flisboac/mixlib-kicad/mixlib-kicad.kicad_pcb

## KiCad design mixlib-kicad.kicad_pcb (2026-07-14)

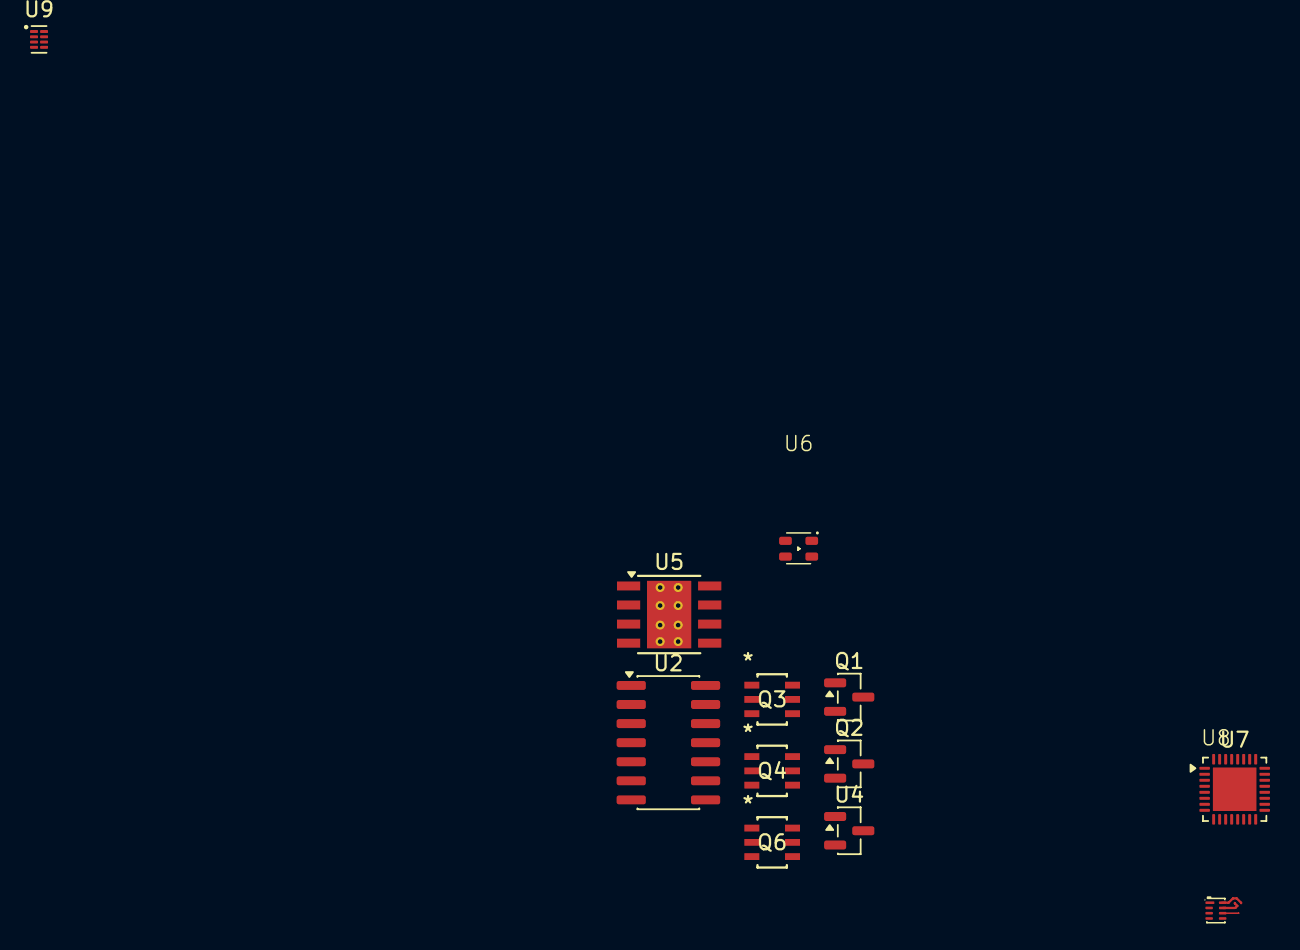
[picture p1: board mixlib-kicad.kicad_pcb from above]

Board: 2 copper layers, 12 parts (0 on the bottom side), 7 nets.

Parts:
Q1, Q2: MMBT5551L; SOT-23
Q3: PMD3001D; SC-74_SOT-457_NEX
Q4: PBSS4160DS; SC-74_SOT-457_NEX
Q6: PBSS4160DPN; SC-74_SOT-457_NEX
U2: MCP6404; SOIC-14_3.9x8.7mm_P1.27mm
U4: LM4040DBZ-10; SOT-23
U5: TPS5430DDA; TI_SO-PowerPAD-8_ThermalVias
U6: TJ-S1615CY6TGLCCYRGY-A5; LED-3_RGB-0603_1615Metric
U7: CH32V006K8U6; QFN-32-1EP_4x4mm_P0.4mm_EP2.9x2.9mm
U8: TXS0102DQE; vendor-ti-DQE0008A
U9: TXS0102DQE; X2SON-8_1.4x1mm_P0.35mm

Connections:
/VCC: U2.4 (V+), U5.5 (EN), U5.7 (VIN)
/VDRIVER_BASE: Q3.1 (B), Q6.1 (C1)
/VDRIVER_SW: Q6.2 (B1), Q6.3 (C2)
/VDRIVER_VCC: Q3.5 (C1_1), Q3.6 (C1_2)
/VDRIVER_VSS: Q3.2 (C2_1), Q3.3 (C2_2)
/VOUT: Q1.3 (C), Q2.3 (C)
GND: Q1.2 (E), Q2.2 (E), Q4.3 (C2), Q4.4 (E2), Q4.5 (B2), Q6.5 (B2), U2.11 (V-), U4.2 (A), U5.6 (GND), U5.9 (GNDPAD)
