flisboac/mixlib-kicad/(commit log)

2025-04-15 feat: add various breakout boards
2025-04-15 feat(pmic/battery): add BQ25672RQMR
    [mixlib-kicad.kicad_pcb, mixlib-kicad.kicad_sch]
2025-04-17 refactor(pmic/battery): bq25672: update symbol
2025-04-18 feat(connector/jumper): add 4-way solder jumper
2025-04-18 refactor(connector/jumper): make 4-way solder jumper smaller
2025-04-18 refactor(connector/jumper): adjust 4-way solder jumper smaller symbol shape
2025-04-20 feat(discrete/mosfet): add BSS138PS
2025-04-20 feat(discrete/mosfet): add Si7223DN and Si7224DN
2025-04-21 feat(pmic/battery): add MAX172x5G, MAX17055ETB
2025-04-21 refactor(pmic/battery): MAX172x5G, MAX17055ETB: reduce symbol size
    [mixlib-kicad.kicad_sch]
2025-04-21 refactor(pmic/battery): MAX172x5G: reorder CELL pins
2025-04-22 fix(pmic/vreg): TPS63070: set proper default footprint and adjust footprint filters
2025-04-25 fix(pmic/battery): MAX172x5G: adjust footprint to the correct size
2025-04-27 feat(discrete/mosfet): add DMC3025LDV
2025-04-27 fix(discrete/mosfet): DMC3025LDV: adjust number of pins
2025-05-04 feat(mosfet): add DMT6005LPS, STL130N6F7
2025-05-04 refactor(mosfet): redefine path for 3d models in terms of user-provided path MIXLIB_KICAD_3DMODELS_DIR
2025-05-06 feat(discrete/mosfet): footprints: make it easier to connect heatpads to their respective pins
2025-05-12 feat(spice): add op-amp: ADA4522
    [mixlib-kicad.kicad_pcb]
2025-05-18 feat: various improvements, components and simulation scripts
    [mixlib-kicad.kicad_sch]
2025-05-18 feat: add common schottky diodes
2025-05-18 feat: add various MOSFETs
2025-05-18 fix: simplify some MOSFET footprints and add missing simulation scripts
    [mixlib-kicad.kicad_sch]
2025-05-18 chore: saving project state
    [mixlib-kicad.kicad_sch]
2025-05-18 add: copy ADA4522 from KiCad and assign default simulation scripts
2025-05-18 fix: various fixes
    [mixlib-kicad.kicad_sch]
2025-05-24 feat: add some bjt transistors and fix simulation scripts
    [mixlib-kicad.kicad_pcb, mixlib-kicad.kicad_sch]
2025-05-25 feat(discrete/npn): PMD3001D: redesign symbol
    [mixlib-kicad.kicad_sch]
2025-05-25 feat: add npn/pnp and zener parts
    [ZMM1-ZMM36.csv, ZMM39-ZMM75.csv]
2025-10-11 refactor(discrete-mosfet): Si4599: remodel as two distinct MOSFET symbols
2025-10-11 refactor(discrete-mosfet): Si4599: move to the proper symbol library and add SPICE models
2025-10-11 refactor(discrete-mosfet): Si4599: center symbol
2025-10-11 refactor(misc-board): sparkfin_max17048: add footprint and reassign pins
2025-10-11 feat(discrete-mosfet): add FS8205A 8-pin
2025-10-12 feat(pmic-board): add generic TP4056 charger board with DW01 Battery protection
2025-10-12 fix(pmic-board): TP4056_DW01_Charger: assign the default footprint
2025-10-12 feat(pmic-supervisor): add RT9829
    [mixlib-kicad.kicad_sch]
2025-10-12 feat(pmic-switch): add LM66200
2025-10-14 refactor(pmid/battery): BQ24295: reorganize pins
2025-10-17 feat(discrete/led): add SK6805-EC14
2025-10-18 fix: correct minor mistakes in footprints and 3d models
2025-10-20 feat: add cheap environment sensor boards' symbols and footprints
2025-10-20 feat(pmic-board): XL63070: add footprint
2025-10-20 feat(discrete-board): add SparkFun Logic Level Converter V2
2025-10-20 fix(discrete-board): Sparkfun_LogicLevelConverter_V2: reorder pins and add footprint
2025-10-20 feat(soc-board): add ESP32-S3-Pico
2025-10-22 feat(discrete/board): add XL0401 Ideal diode board
2025-10-22 fix(discrete/board): XL0401_IdealDiode: fix footprint pinout
2025-10-22 refactor(discrete/board): Sparkfun_LogicLevelConverter_V2: resize symbol to be smaller
2025-10-28 feat(misc/board): add Generic_TXS0108_Board
2026-01-28 feat(pmic-battery): add AXP2585
2026-02-12 feat: add a bunch of new components
    [mixlib-kicad.kicad_pcb]
2026-02-12 feat(mixlib-discrete-led): reduce ARGB components' footprints
2026-02-14 feat: add first-pin indicator on footprints lacking such
2026-02-16 feat(discrete-mosfet): add SiA931DJ
2026-02-16 feat(electromechanic-switch): add MSK-12C01
2026-02-16 refactor(pmic-switch): TPS2116, TPS2117: improve symbol pin spacing
2026-02-16 feat(electromechanic-switch): add TS-A002
2026-02-16 feat(electromechanic-switch): fix MSK-12C01 footprint association
2026-02-18 feat: add small form-factor MOSFETs
2026-02-18 feat(discrete-mosfet): add Si1539CDL
2026-02-20 feat: add many small form-factor MOSFETs
2026-02-23 refactor(electromechanic-switch): TS-A002: add 3D model
2026-03-09 feat(discrete-mosfet): add DMN3032LFDBQ
2026-03-09 fix(discrete-mosfet): si3993CDV: fix symbol pinouts
2026-03-15 feat(soc-stm32g0): add STM32G071G8Ux (28-pin) and variants
2026-03-15 fix: put some footprints in the correct folders
2026-03-15 fix(pmic-battery): minor adjustments to MAX17055 footprint
2026-03-16 fix(pmic-battery): bq25672: minor adjustments to the footprint
    [mixlib-kicad.kicad_pcb]
2026-03-17 feat: add many mosfets
2026-03-26 feat(pmic-battery_: add BQ25620
2026-03-26 fix(pmic-battery): BQ25620: set correct 3D model path
2026-03-27 feat(pmic-switch): add TPS2121
2026-03-28 refactor(pmic-switch): TPS2121: reposition CP2 pin in symbol
2026-03-28 refactor(pmic-switch): TPS2121: reposition symbol pins
    [mixlib-kicad.kicad_sch]
2026-03-29 feat(discrete-led): add generic Aliexpress 0603 discrete LED
    [mixlib-kicad.kicad_sch]
2026-03-29 refactor(discrete-led): rearrange generic Aliexpress 0603 discrete LED symbol
    [mixlib-kicad.kicad_sch]
2026-05-02 feat(discrete-mosfet): add DMN31D5UDJ
    [mixlib-kicad.kicad_pcb, mixlib-kicad.kicad_sch]
2026-05-04 feat(pmic-battery): add BQ25628 and BQ25629
2026-06-07 feat(ic-mcu): add CH32V/CH32F MCUs
    [mixlib-kicad.kicad_sch]
2026-06-07 feat(pmic-switch): add CH213K and CH217K
2026-06-07 feat(interface-uart): add THVD1400
2026-07-14 feat(connector-general): add barrel jack connector with 3D model
    [mixlib-kicad.kicad_pcb, mixlib-kicad.kicad_sch]
2026-07-17 feat(discrete-resistor): add small-symbol 4-pin resistor pack
    [mixlib-kicad.kicad_sch]
